levkropp/sesame-robot-pca9685/hardware/pcb/distro-v3/assets/close-v3.png

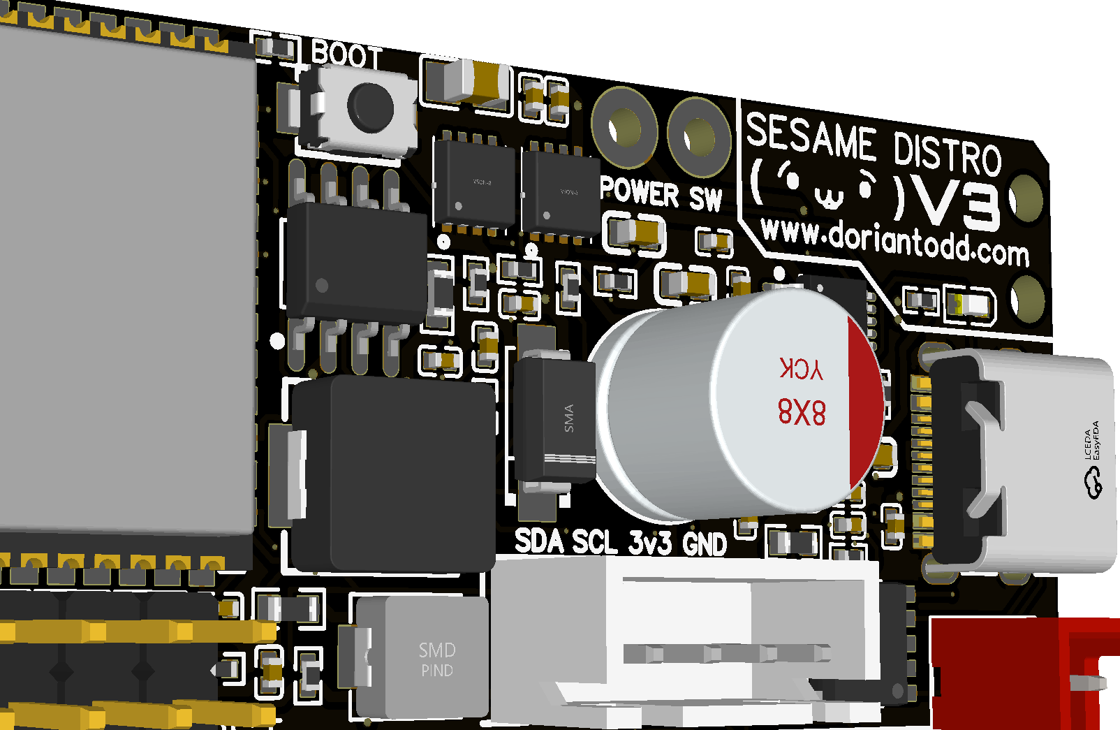
hardware/pcb/distro-v3/assets/close-v3.png
