levkropp/sesame-robot-pca9685/hardware/pcb/distro-v3/assets/Schematic_Sesame-Distro-Board-V3_2026-05-30.png

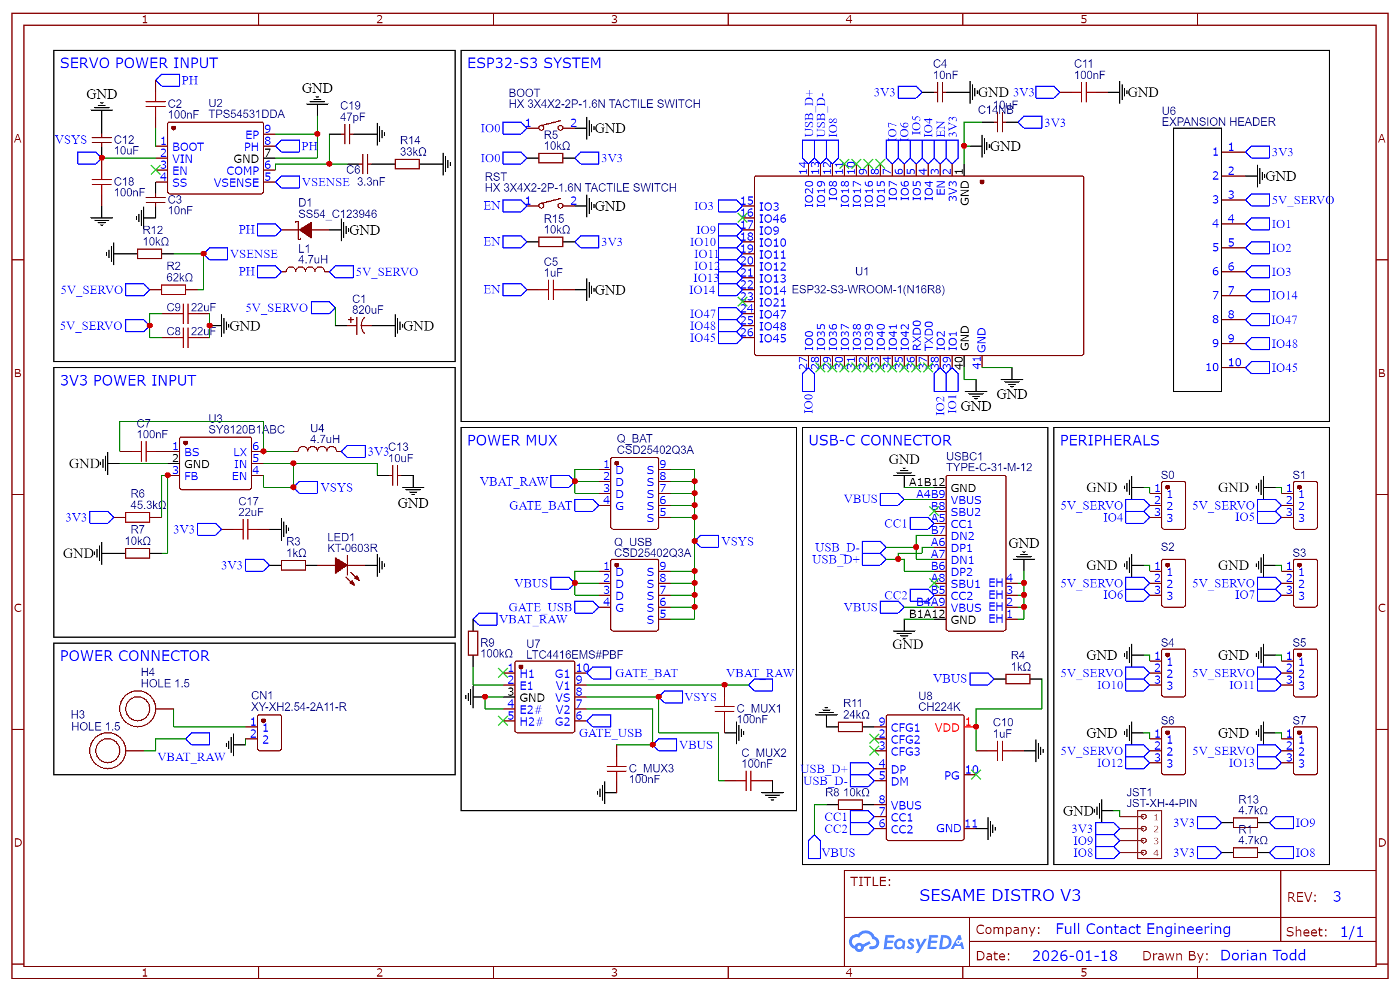
hardware/pcb/distro-v3/assets/Schematic_Sesame-Distro-Board-V3_2026-05-30.png
