levkropp/sesame-robot-pca9685/hardware/pcb/SDB-layout.png

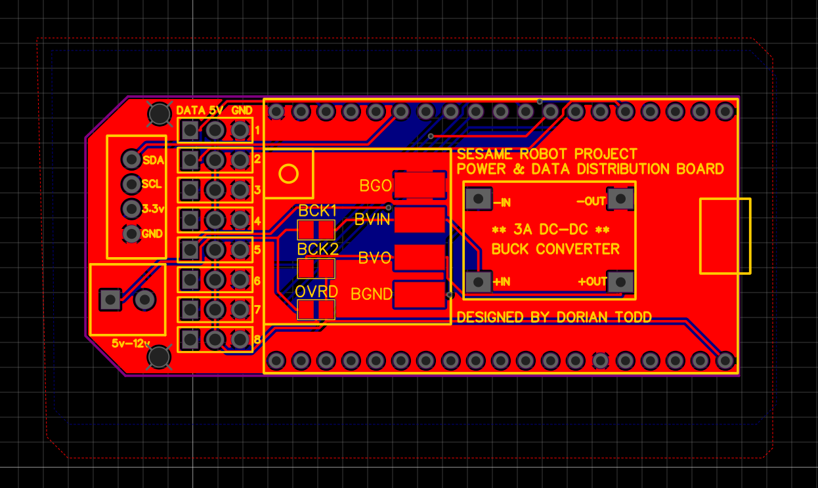
hardware/pcb/SDB-layout.png
