levkropp/sesame-robot-pca9685/software/sesame-studio/assets/sesame-sticker2.png

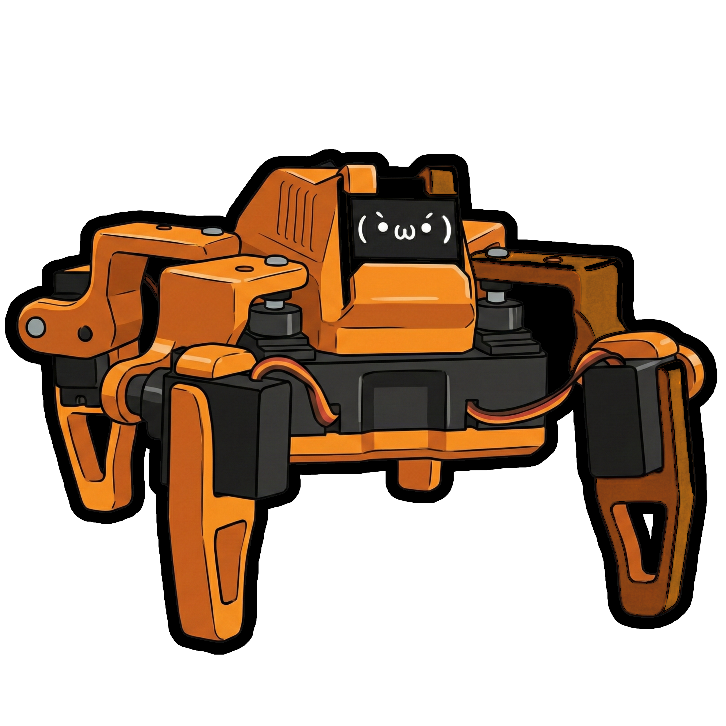
software/sesame-studio/assets/sesame-sticker2.png
