levkropp/sesame-robot-pca9685/software/sesame-studio/assets/sesamestudio-preview.png

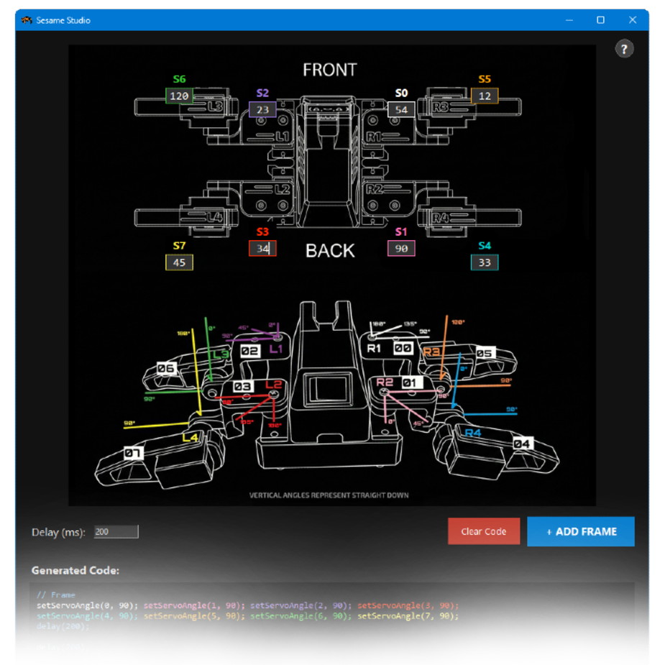
software/sesame-studio/assets/sesamestudio-preview.png
