levkropp/sesame-robot-pca9685/hardware/pcb/distro-v3/BOM_Sesame-Distro-Board-V3.csv

ID | Name | Designator | Footprint | Quantity | Manufacturer Part | Manufacturer | Supplier | Supplier Part | Price
1 | 1uF | C10 | C0402 | 1 | CC0402MRY5V6BB105 | YAGEO(国巨) | LCSC | C527031 | 0.006
2 | XY-XH2.54-2A11-R | CN1 | CONN-TH_2P-P2.50_C9900022029 | 1 | XY-XH2.54-2A11-R | XYECONN(辛译) | LCSC | C22391422 | 0.015
3 | 1kΩ | R4,R3 | R0402 | 2 | 0402WGF1001TCE | UNI-ROYAL(厚声) | LCSC | C11702 | 0.001
4 | 10kΩ | R8,R5,R7,R12,R15 | R0402 | 5 | 0402WGF1002TCE | UNI-ROYAL(厚声) | LCSC | C25744 | 0.001
5 | HX 3X4X2-2P-1.6N TACTILE SWITCH | RST,BOOT | KEY-SMD_L4.0-W3.0-LS4.9-1 | 2 | HX 3x4x2-2P-1.6N TACTILE SWITCH | hanxia(韩下) | LCSC | C49234124 | 0.019
6 | HOLE 1.5 | H3,H4 | HOLEHOLE | 2 |  |  |  | No Part Required
7 | LTC4416EMS#PBF | U7 | MSOP-10_L3.0-W3.0-P0.50-LS5.0-BL | 1 | LTC4416EMS#PBF | ADI(亚德诺) | LCSC | C694754 | 8.147
8 | 820uF | C1 | CAP-TH_BD8.0-P3.50-D0.6-FD | 1 | E2821M010D120RL | 瑞隆 | LCSC | C2898774 | 0.123
9 | 100nF | C2,C7,C18 | C0402 | 3 | VJ0402Y104KXJPW1BC | VISHAY(威世) | LCSC | C3891429 | 0.073
10 | 10nF | C4 | C0402 | 1 | CL05B103KB5NNNC | SAMSUNG(三星) | LCSC | C15195 | 0.002
11 | 1uF | C5 | C0402 | 1 | CL05A105KA5NQNC | SAMSUNG(三星) | LCSC | C52923 | 0.005
12 | 100nF | C11,C_MUX1,C_MUX2,C_MUX3 | C0402 | 4 | MC0402B104K500N5RH | Sunway(信维通信) | LCSC | C3152552
13 | 10uF | C12,C13,C14NB | C0402 | 3 | CL05A106MQ5NUNC | SAMSUNG(三星) | LCSC | C15525 | 0.017
14 | 47pF | C19 | C0402 | 1 | 0402CG470J500NT | FH(风华) | LCSC | C1567 | 0.001
15 | 4.7kΩ | R1,R13 | R0402 | 2 | 0402WGF4701TCE | UNI-ROYAL(厚声) | LCSC | C25900 | 0.001
16 | 100kΩ | R9 | R0402 | 1 | 0402WGF1003TCE | UNI-ROYAL(厚声) | LCSC | C25741 | 0.001
17 | 24kΩ | R11 | R0603 | 1 | 0603WAF2402T5E | UNI-ROYAL(厚声) | LCSC | C23352 | 0.002
18 | 33kΩ | R14 | R0402 | 1 | 0402WGF3302TCE | UNI-ROYAL(厚声) | LCSC | C25779 | 0.001
19 | 10nF | C3 | C0805 | 1 | CL21B103KBANNNC | SAMSUNG(三星) | LCSC | C1710 | 0.008
20 | 3.3nF | C6 | C0603 | 1 | CL10B332KB8NNNC | SAMSUNG(三星) | LCSC | C1613 | 0.006
21 | 22uF | C8,C9,C17 | C0603 | 3 | CL10A226MQ8NRNC | SAMSUNG(三星) | LCSC | C59461 | 0.013
22 | SS54_C123946 | D1 | SMA_L4.4-W2.8-LS5.4-RD | 1 | SS54 | 晶导微电子 | LCSC | C123946 | 0.052
23 | JST-XH-4-PIN | JST1 | JST-XH-4PIN-2.5 | 1 |  |  |  | C144395 | 0.054
24 | 4.7uH | L1 | IND-SMD_L7.0-W6.6_APH0630 | 1 | APH0630T4R7M | APV(爱普微) | LCSC | C5349705 | 0.072
25 | KT-0603R | LED1 | LED0603-RD | 1 | KT-0603R | KENTO | LCSC | C2286 | 0.007
26 | CSD25402Q3A | Q_BAT,Q_USB | VSONP-8_L3.1-W3.1-P0.65-LS3.5-BL | 2 | CSD25402Q3A | TI(德州仪器) | LCSC | C111356 | 0.638
27 | 62kΩ | R2 | R0603 | 1 | RT0603BRD0762KL | YAGEO(国巨) | LCSC | C136961 | 0.026
28 | 45.3kΩ | R6 | R0603 | 1 | RMC 0603 45K3 F N | Tyohm(幸亚电阻) | LCSC | C325695 | 0.004
29 | HX | S0 | HDR-TH_3P-P2.54-V-M-1 | 1 | HX PH254-01-03-Z-L11.5 pcb pin header | hanxia(韩下) | LCSC | C52016391 | 0.023
30 | HX PH254-01-03-Z-L11.5 PCB PIN HEADER | S1,S2,S3,S4,S5,S6,S7 | HDR-TH_3P-P2.54-V-M-1 | 7 | HX PH254-01-03-Z-L11.5 pcb pin header | hanxia(韩下) | LCSC | C52016391 | 0.023
31 | ESP32-S3-WROOM-1(N16R8) | U1 | WIRELM-SMD_ESP32-S3-WROOM-1 | 1 | ESP32-S3-WROOM-1-N16R8 | ESPRESSIF(乐鑫) | LCSC | C2913202 | 5.389
32 | TPS54531DDA | U2 | SOIC-8_L4.9-W3.9-P1.27-LS6.0-BL-EP2.9 | 1 | TPS54531DDA | TI(德州仪器) | LCSC | C544938 | 0.631
33 | SY8120B1ABC | U3 | SOT-23-6_L2.9-W1.6-P0.95-LS2.8-BL | 1 | SY8120B1ABC | Silergy(矽力杰) | LCSC | C88474 | 0.161
34 | 4.7uH | U4 | IND-SMD_L4.4-W4.2 | 1 | APH0420T4R7M | APV(爱普微) | LCSC | C5349668 | 0.081
35 | EXPANSION HEADER | U6 | HEADER MALE 2.54-1*10 | 1 |  |  |  | No Part Required
36 | CH224K | U8 | ESSOP-10_L4.9-W3.9-P1.0-LS6.0-TL-EP | 1 | CH224K | WCH(南京沁恒) | LCSC | C970725 | 0.616
37 | TYPE-C-31-M-12 | USBC1 | USB-C_SMD-TYPE-C-31-M-12_1 | 1 | TYPE-C-31-M-12 | 韩国韩荣 | LCSC | C165948 | 0.188
