levkropp/sesame-robot-pca9685/hardware/printing/stl/R1-v117.stl

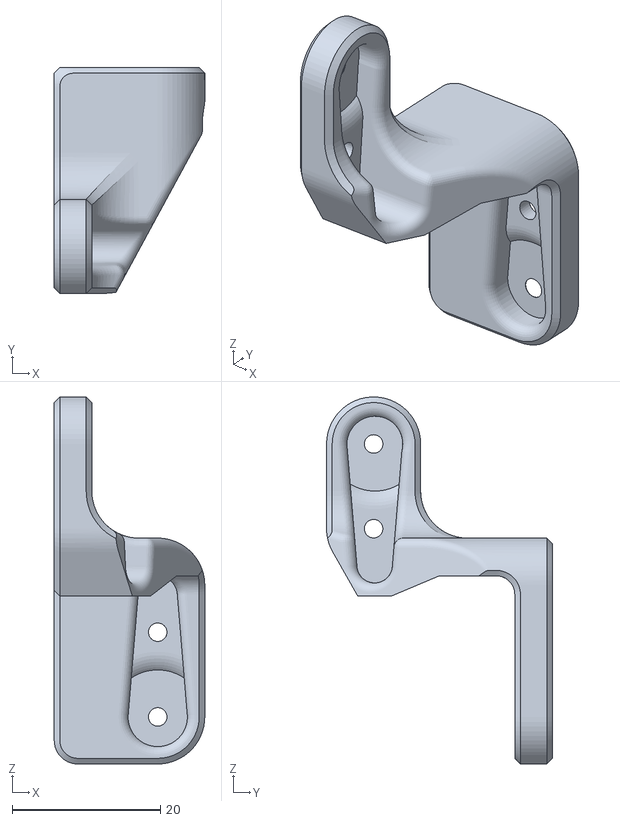
[picture p9: CAD file, 2026-07-29]
hardware/printing/stl/R1-v117.stl
20.3 x 30.5 x 49.5
