levkropp/sesame-robot-pca9685/hardware/printing/stl/top-covers/hats/magnetic-modular-mount-hat.stl

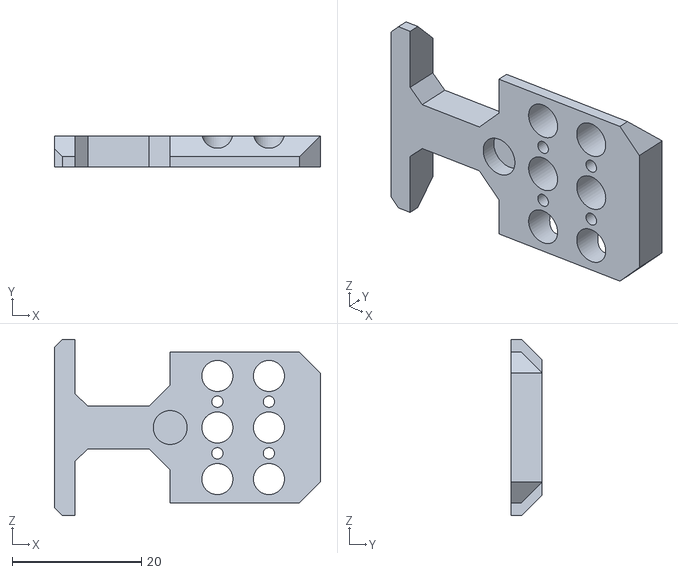
[picture p10: CAD file, 2026-07-29]
hardware/printing/stl/top-covers/hats/magnetic-modular-mount-hat.stl
41.1 x 4.79 x 27.3
