levkropp/sesame-robot-pca9685/hardware/printing/stl/top-covers/Top-Cover-Cat-v100.stl

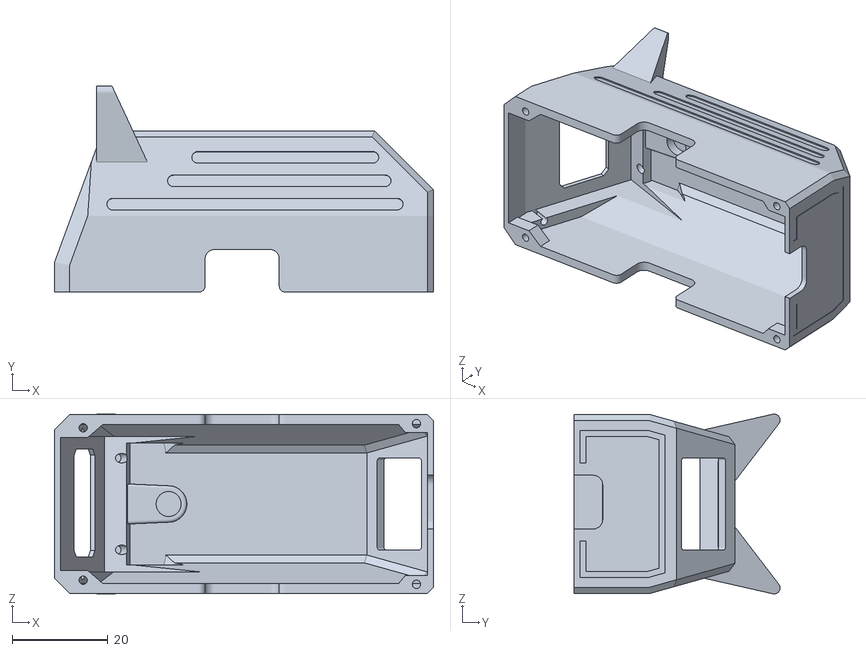
[picture p11: CAD file, 2026-07-29]
hardware/printing/stl/top-covers/Top-Cover-Cat-v100.stl
79.2 x 43.1 x 37.6
