levkropp/sesame-robot-pca9685/hardware/printing/stl/top-covers/hats/magnetic-chainsaw-hat.stl

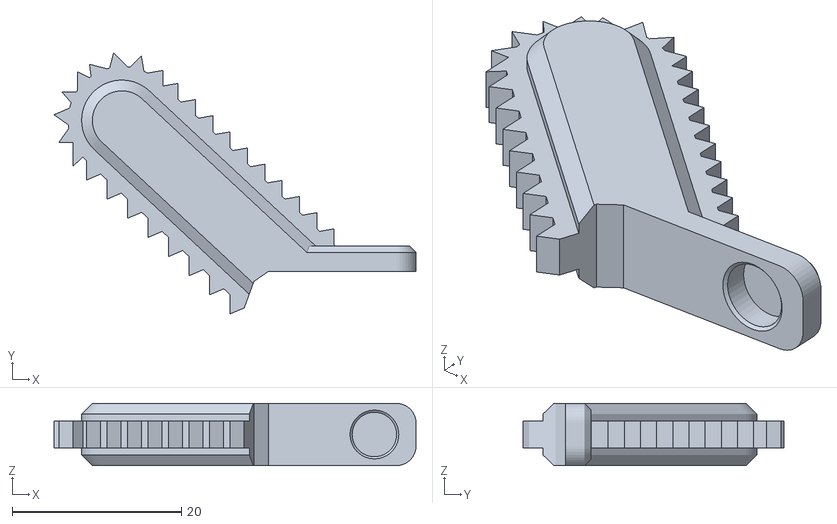
[picture p12: CAD file, 2026-07-29]
hardware/printing/stl/top-covers/hats/magnetic-chainsaw-hat.stl
42.8 x 30.8 x 7.34
