levkropp/sesame-robot-pca9685/hardware/printing/stl/top-covers/Top-Cover-Enclosed-v117.stl

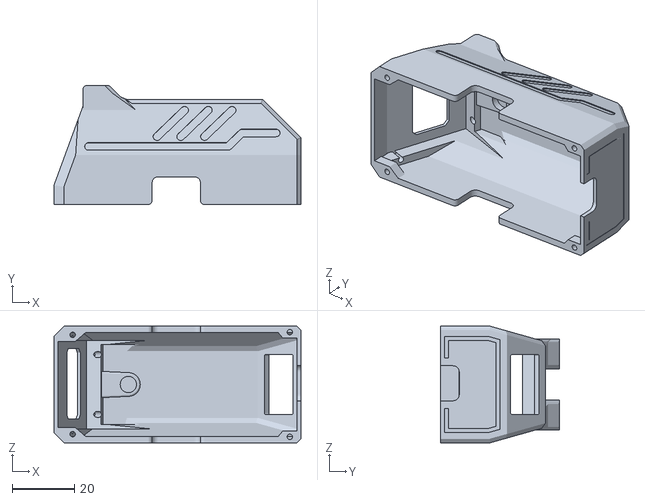
[picture p13: CAD file, 2026-07-29]
hardware/printing/stl/top-covers/Top-Cover-Enclosed-v117.stl
79.2 x 38.2 x 37.4
