levkropp/sesame-robot-pca9685/hardware/printing/stl/L3-v117.stl

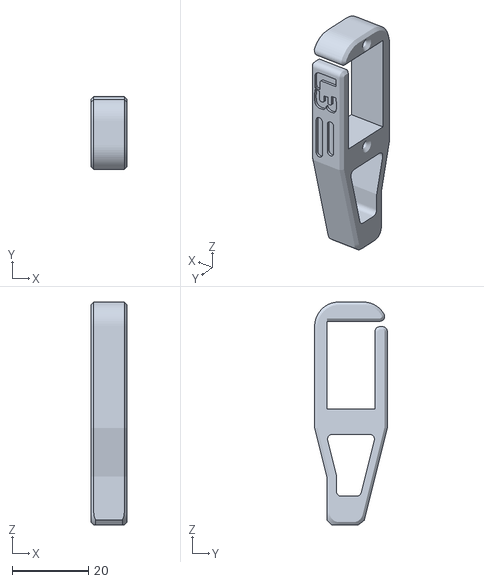
[picture p14: CAD file, 2026-07-29]
hardware/printing/stl/L3-v117.stl
9.53 x 19.0 x 58.4
