levkropp/sesame-robot-pca9685/hardware/printing/stl/top-covers/Top-Cover-No-Ears-v100.stl

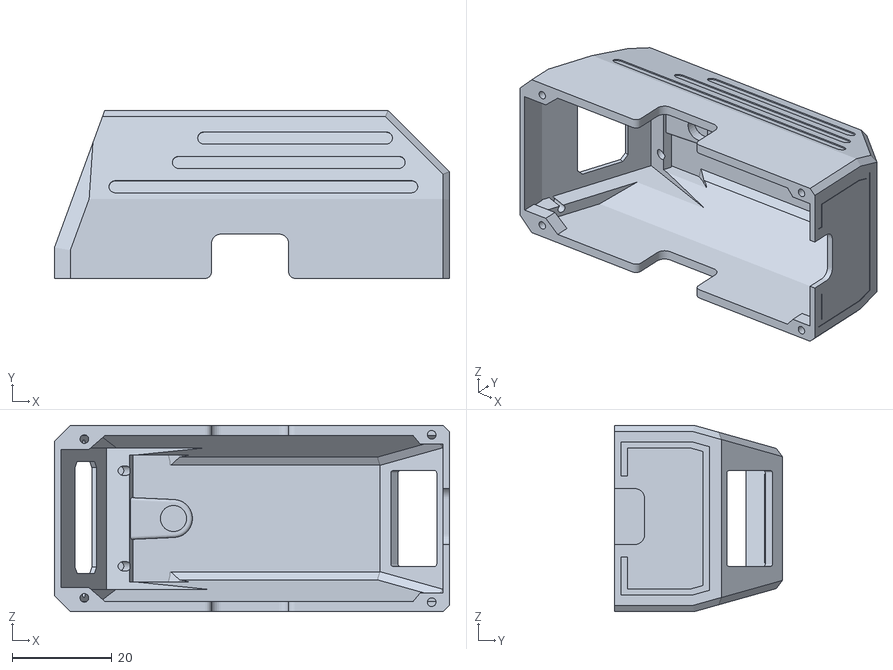
[picture p15: CAD file, 2026-07-29]
hardware/printing/stl/top-covers/Top-Cover-No-Ears-v100.stl
79.2 x 33.7 x 37.4
