levkropp/sesame-robot-pca9685/hardware/printing/stl/Internal-Frame-v121.stl

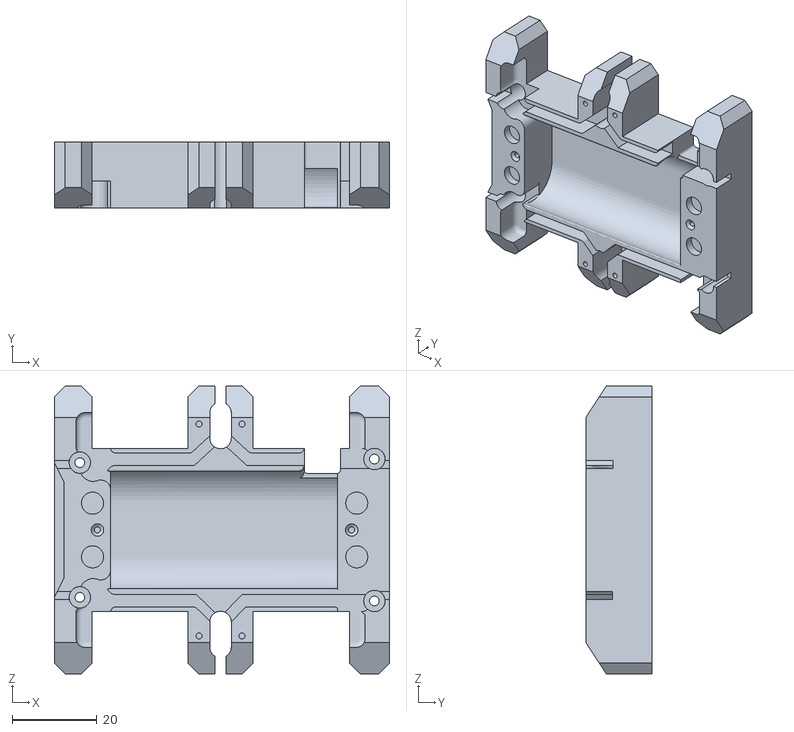
[picture p16: CAD file, 2026-07-29]
hardware/printing/stl/Internal-Frame-v121.stl
79.2 x 15.7 x 68.1
