levkropp/sesame-robot-pca9685/hardware/printing/stl/Bottom-Cover-v121.stl

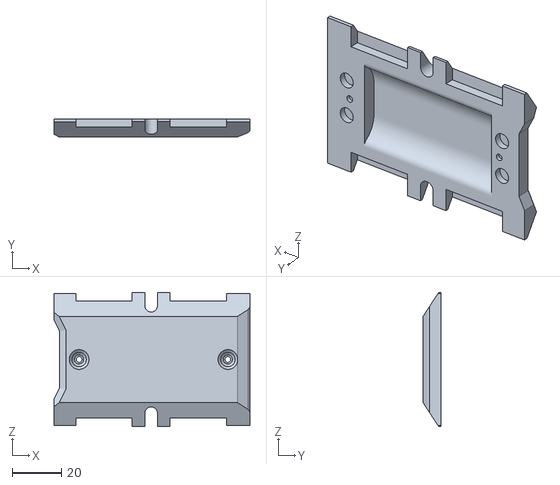
[picture p17: CAD file, 2026-07-29]
hardware/printing/stl/Bottom-Cover-v121.stl
79.2 x 7.27 x 54.2
