levkropp/sesame-robot-pca9685/(list of files, cad)

Other CAD files:
hardware/printing/stl/R2-v117.stl
hardware/printing/stl/L1-v117.stl
hardware/printing/stl/top-covers/Top-Cover-Enclosed-v117-PCA9685-sunroof.stl
hardware/printing/stl/L4-v117.stl
hardware/printing/stl/top-covers/Top-Cover-Enclosed-v117-shell-only.stl
hardware/printing/stl/R4-v117.stl
hardware/printing/stl/L2-v117.stl
hardware/printing/stl/R3-v117.stl
