levkropp/sesame-robot-pca9685/hardware/printing/README.md

# 3D Printing Guide

Sesame is designed to be printed in **PLA**. Most parts print without supports, but the top cover needs supports in targeted areas. Below is a quick reference for each component:

Note: There are 3 different top cover styles currently available. **Enclosed v91 is recommended** as it's the most modern design with magnetic hat mounts, covered display wires, and multicolor detail support. See [Top Covers](stl/top-covers/) for details on all styles.

> [!NOTE]
> **Battery Upgrade:** The internal frame design has been slightly altered to fit the new recommended battery (Bambu Lab 14500 Li-ion). If you have an older Sesame and want to upgrade to this battery, simply print the new internal frame and install it.

## Recommended Settings

* **Material:** PLA / PLA+
* **Infill:** 8-10%
* **Wall Loops:** 2
* **Infill Pattern:** Honeycomb

## 3D Printed Components Support Guide

| Component | Supports Required | STL Link |
| --- | --- | --- |
| Joint R1 | No | [R1-v117.stl](stl/R1-v117.stl) |
| Joint R2 | No | [R2-v117.stl](stl/R2-v117.stl) |
| Joint R3 | No | [R3-v117.stl](stl/R3-v117.stl) |
| Joint R4 | No | [R4-v117.stl](stl/R4-v117.stl) |
| Joint L1 | No | [L1-v117.stl](stl/L1-v117.stl) |
| Joint L2 | No | [L2-v117.stl](stl/L2-v117.stl) |
| Joint L3 | No | [L3-v117.stl](stl/L3-v117.stl) |
| Joint L4 | No | [L4-v117.stl](stl/L4-v117.stl) |
| Internal Frame | No | [Internal-Frame-v121.stl](stl/Internal-Frame-v121.stl) |
| Bottom Cover | No | [Bottom-Cover-v121.stl](stl/Bottom-Cover-v121.stl) |
| Top Cover | Yes | [Top Covers](stl/top-covers/) |

### Top Cover Settings (Original Style)

Brim: Outer brim only
Support type: Normal (Manual)

Manual support locations:

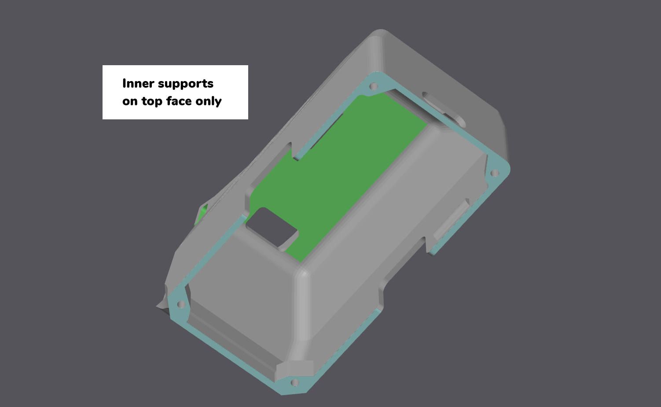
[picture p48: hardware/printing/assets/topcover-supports2.png]
topcover-supports2


This is what the part should look like sliced:

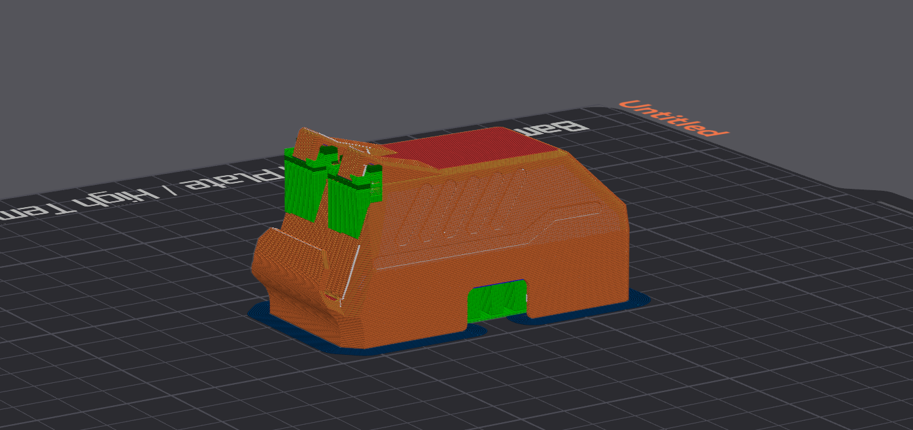
[picture p49: hardware/printing/assets/sliced-topcover.png]
sliced-topcover


### Recommended Print Orientation for Joints:

Using the auto orientate tool will place these the correct way.

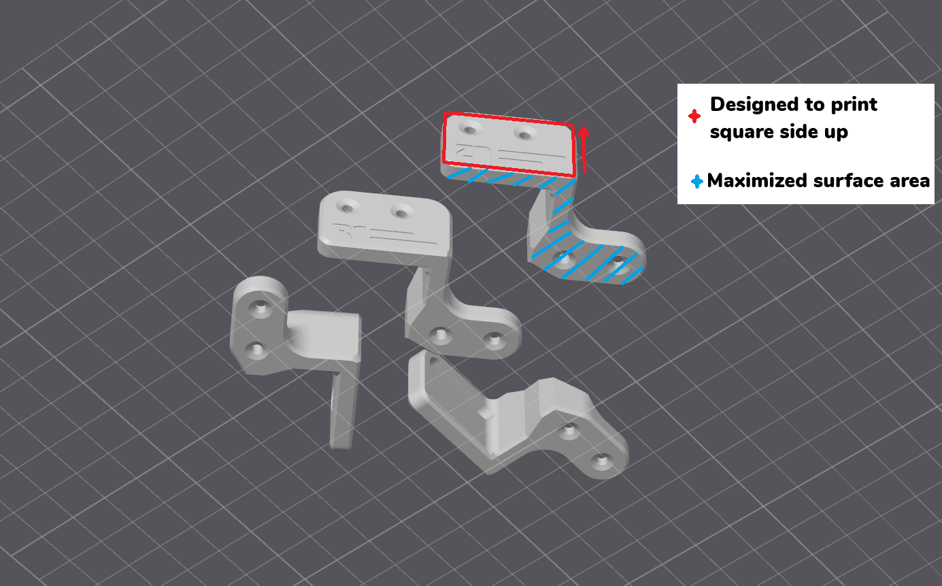
[picture p50: hardware/printing/assets/joints-orientation.png]
