levkropp/sesame-robot-pca9685/docs/build-guide/assets/display-wires.png

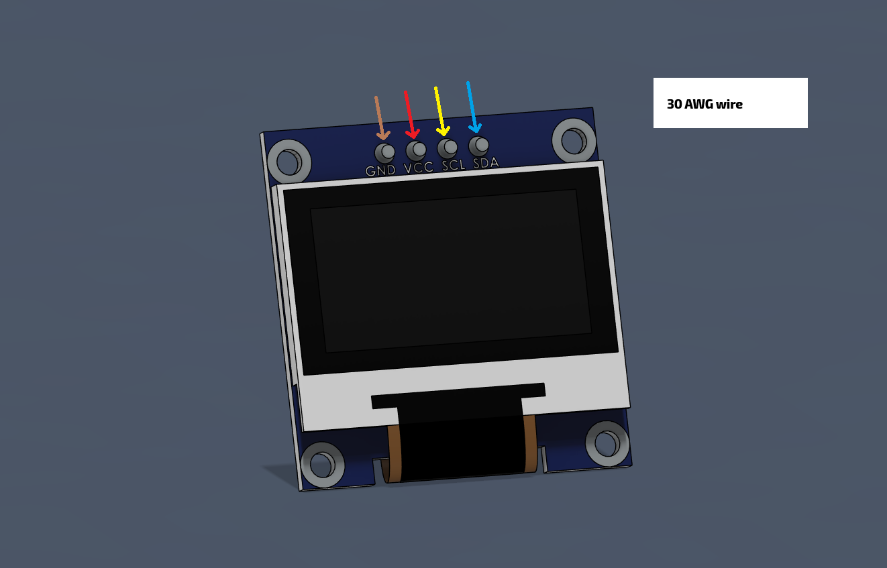
docs/build-guide/assets/display-wires.png
