levkropp/sesame-robot-pca9685/docs/build-guide/assets/insert-display.png

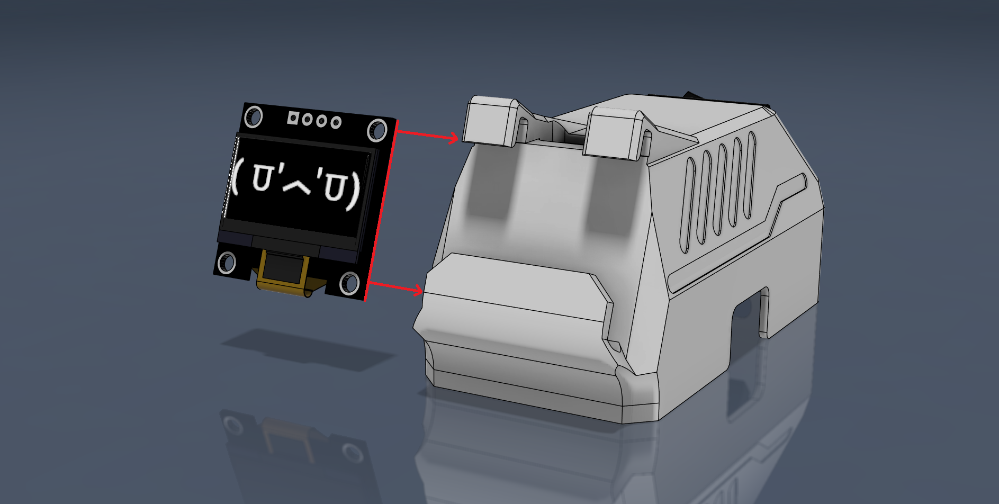
docs/build-guide/assets/insert-display.png
