levkropp/sesame-robot-pca9685/docs/build-guide/assets/joint-horn-install-2.png

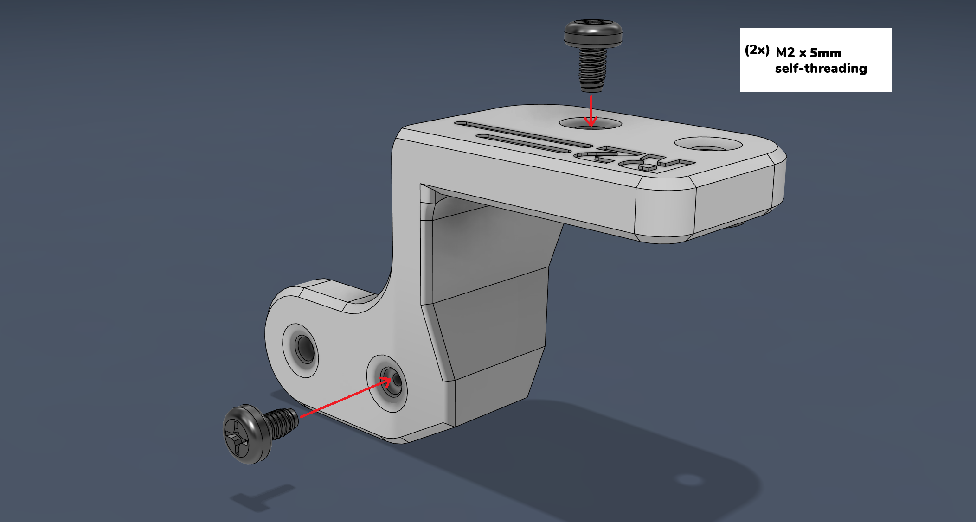
docs/build-guide/assets/joint-horn-install-2.png
