levkropp/sesame-robot-pca9685/docs/build-guide/assets/joints-preassem.png

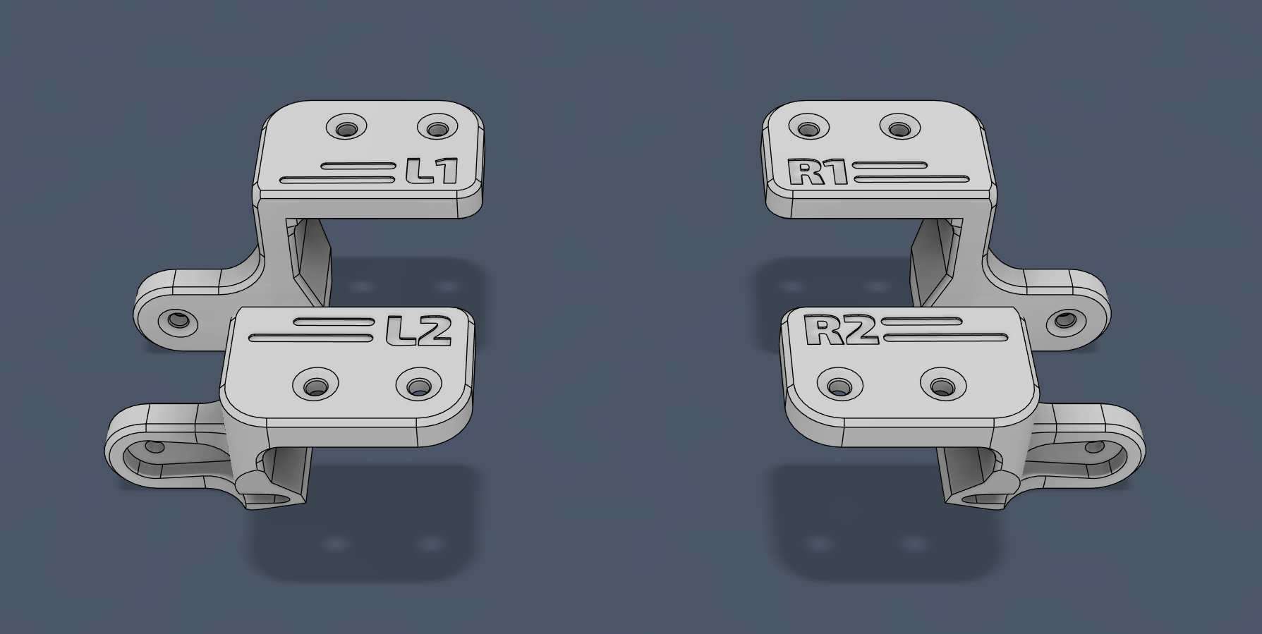
docs/build-guide/assets/joints-preassem.png
