levkropp/sesame-robot-pca9685/docs/build-guide/assets/press-on-bottom-cover.png

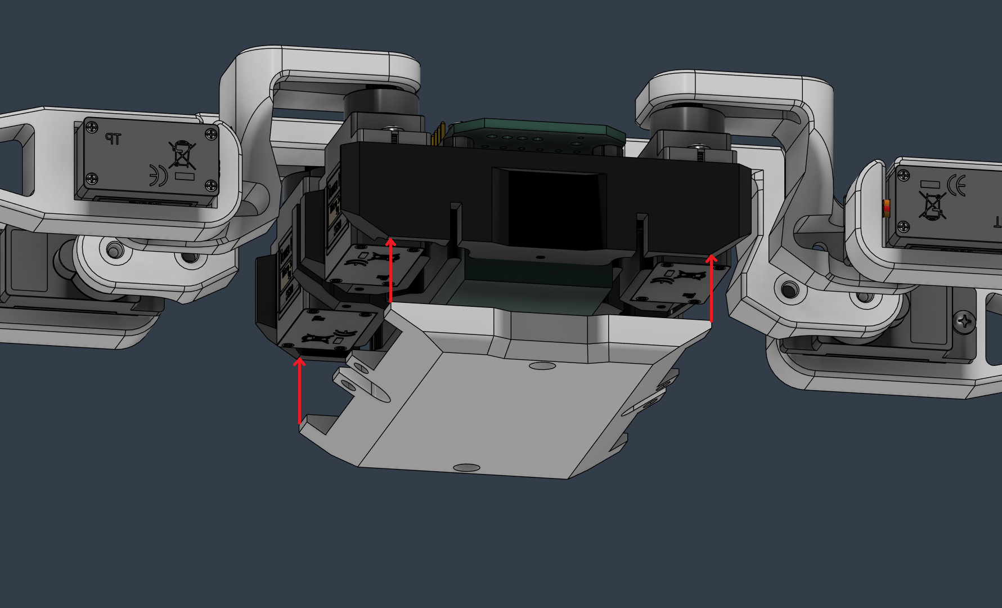
docs/build-guide/assets/press-on-bottom-cover.png
