levkropp/sesame-robot-pca9685/docs/build-guide/assets/push-on-top-cover.png

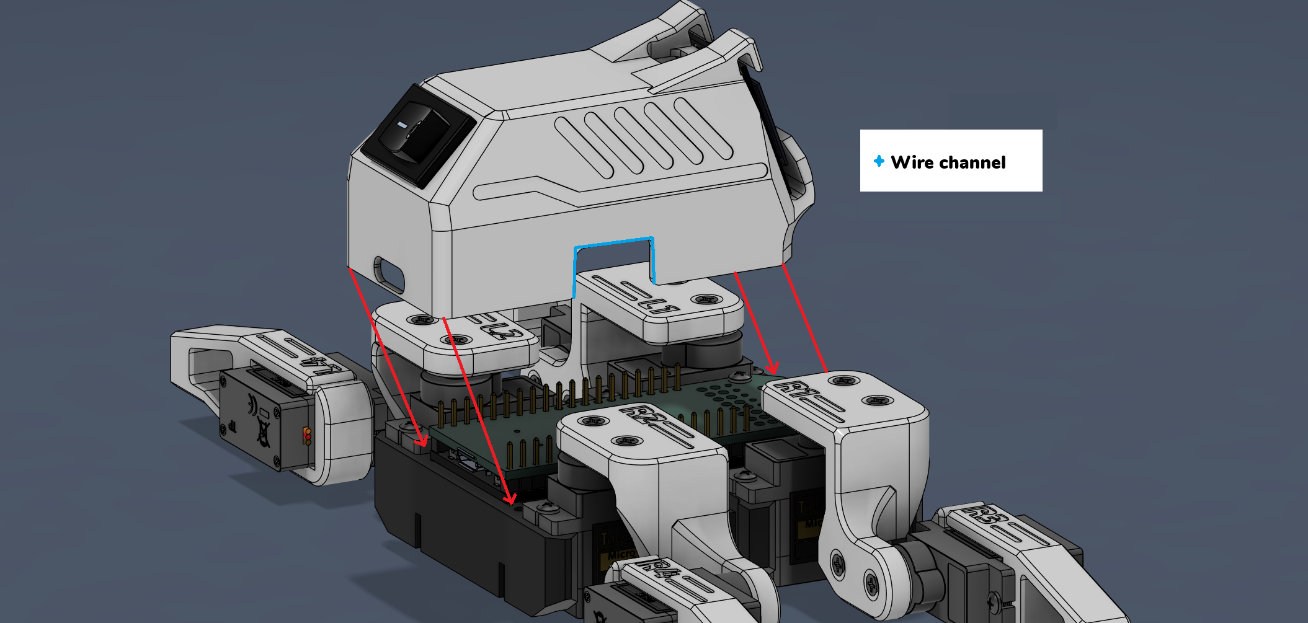
docs/build-guide/assets/push-on-top-cover.png
