levkropp/sesame-robot-pca9685/docs/build-guide/assets/remove-headers.png

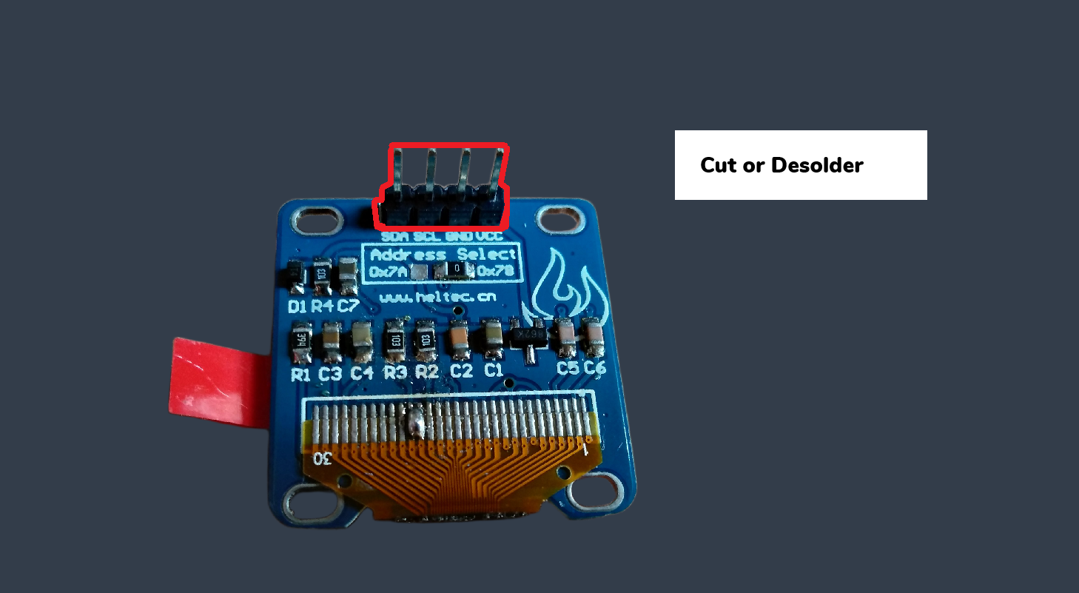
docs/build-guide/assets/remove-headers.png
