levkropp/sesame-robot-pca9685/docs/build-guide/assets/securing-display-enclosed.png

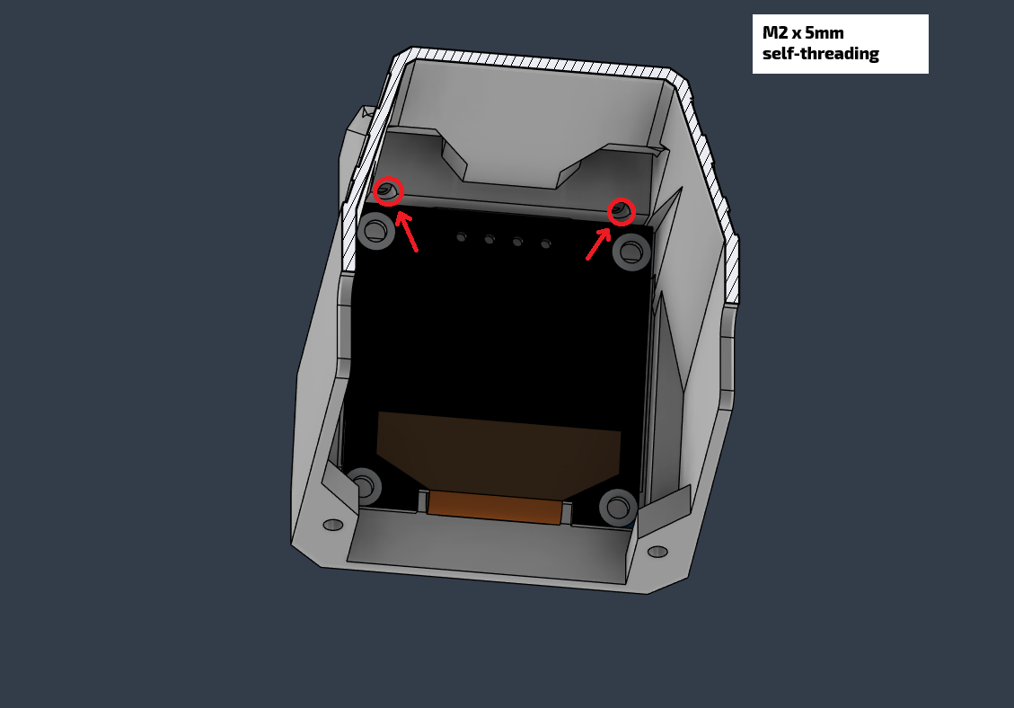
docs/build-guide/assets/securing-display-enclosed.png
