levkropp/sesame-robot-pca9685/docs/build-guide/assets/securing-display.png

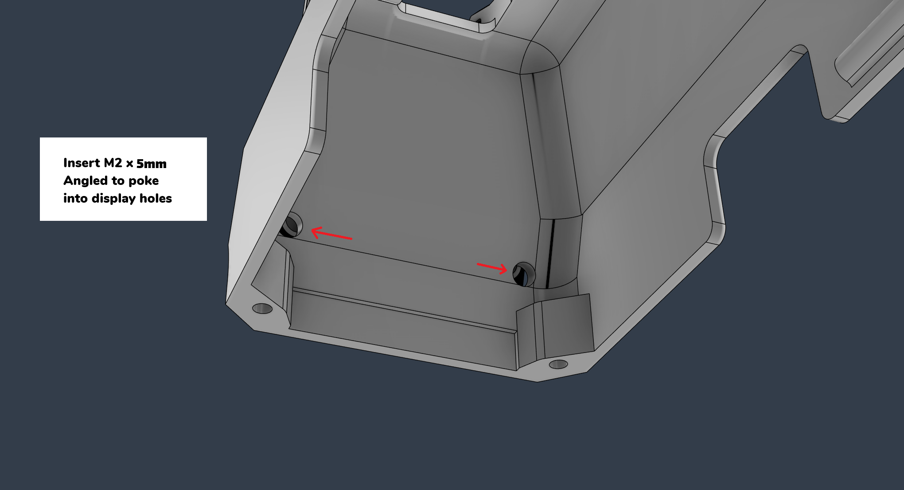
docs/build-guide/assets/securing-display.png
