levkropp/sesame-robot-pca9685/docs/build-guide/assets/top-cover-wiring.png

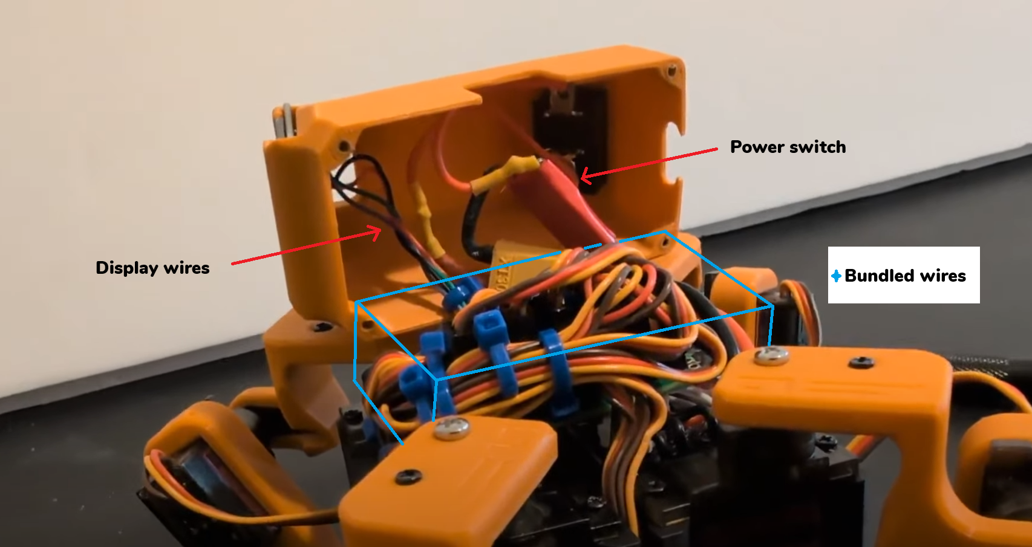
docs/build-guide/assets/top-cover-wiring.png
