levkropp/sesame-robot-pca9685/docs/build-guide/assets/wire-spot.png

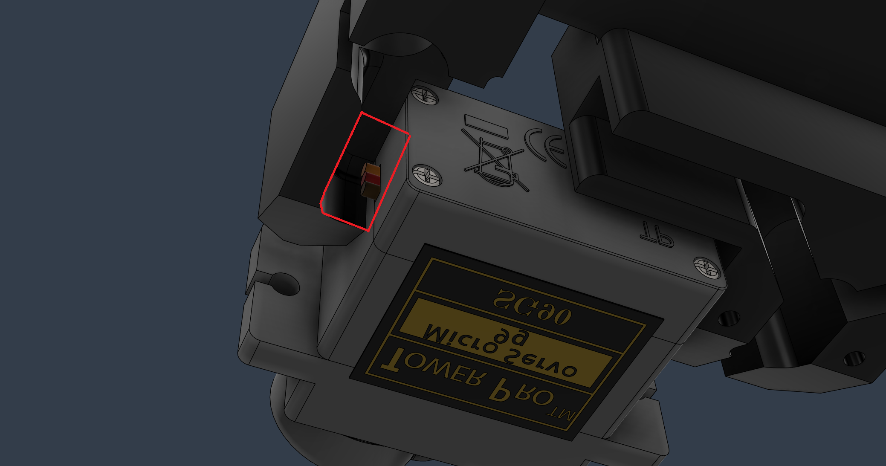
docs/build-guide/assets/wire-spot.png
