levkropp/sesame-robot-pca9685/docs/pca9685-fork/assets/wiring-diagram.png

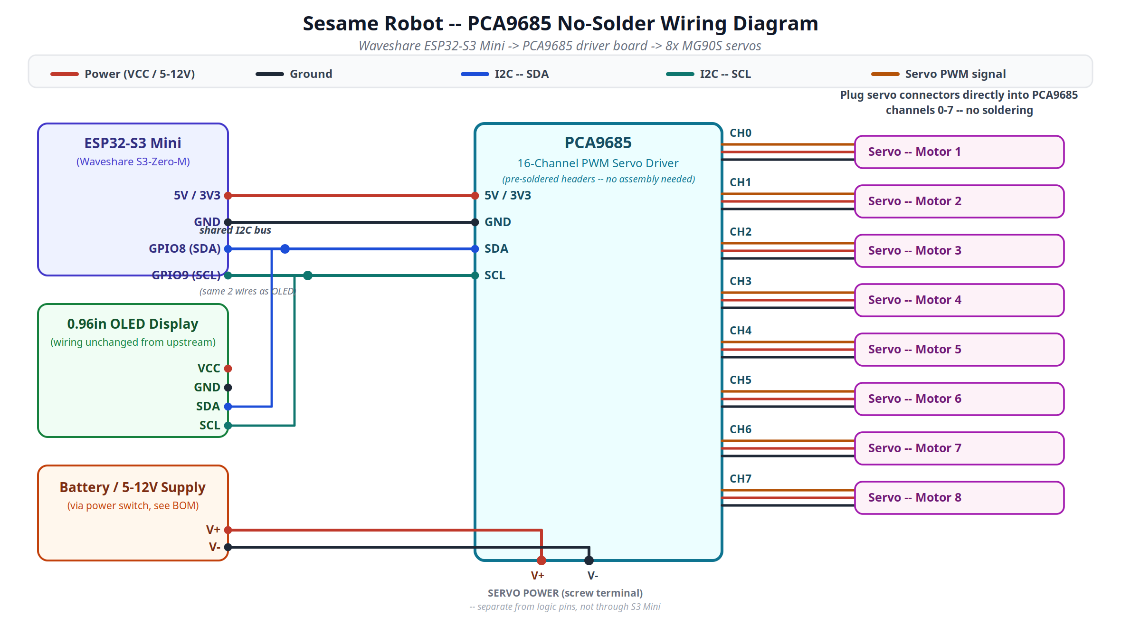
docs/pca9685-fork/assets/wiring-diagram.png
