levkropp/sesame-robot-pca9685/hardware/printing/assets/topcover-supports1.png

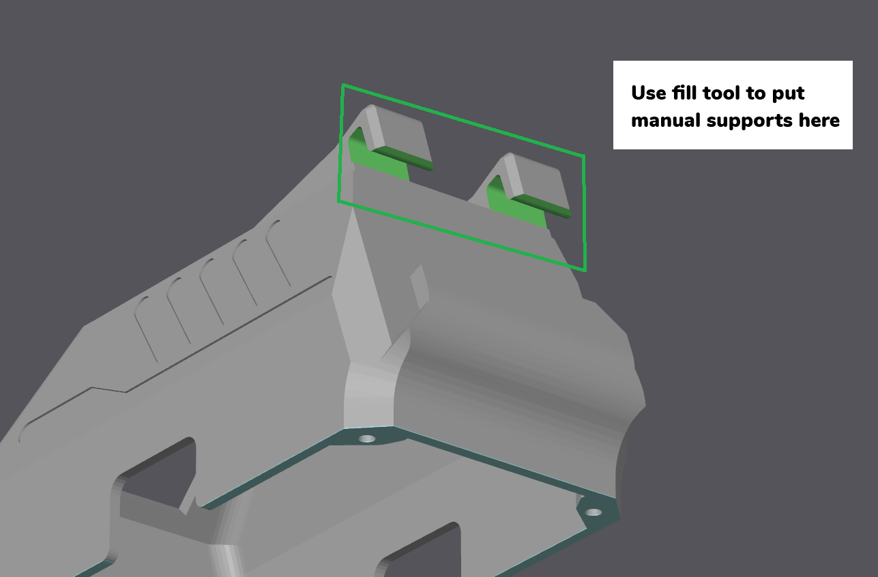
hardware/printing/assets/topcover-supports1.png
