levkropp/sesame-robot-pca9685/(commit log)

2026-07-29 Sesame Robot — PCA9685 no-solder edition (fork of dorianborian/sesame-robot)
    Swaps the hand-wired 3x8 servo header block for a plug-and-play PCA9685
    driver board paired with a pre-soldered Waveshare ESP32-S3-Zero-M, making
    the whole electronics stack zero-solder:
    - firmware: servos driven via Adafruit_PWMServoDriver over I2C (GPIO8/9)
    instead of direct GPIO PWM
    - docs: wiring guide, BOM (two-phase power: tethered USB-C first, battery
    later), fork writeup, corrected 'sunroof' top-cover STL + parametric
    OpenSCAD source for PCA9685 connector access
    - website/: static explainer site, deployed to GitHub Pages by CI
    - simulation/: complete Velxio project (.vlx) that boots the real firmwar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
    [BOM_Sesame-Distro-Board-V3.csv, BOM_Sesame-Distro-V2.csv, Bottom-Cover-v121.stl, Internal-Frame-v121.stl, L1-v117.stl, L2-v117.stl, L3-v117.stl, L4-v117.stl]
2026-07-29 Fix servo power routing in .vlx: servos draw V+/GND through the PCA9685 rail (like the physical module), PSU only feeds the screw terminal
    [generate_vlx.py]
2026-07-29 Event-driven PCA9685 chip + verified end-to-end ESP32-S3 emulation
    - Re-vendor event-driven PCA9685 chip (edge-scheduled one-shot timers,
    global 20ms frame clock, no tick quantization); regenerate .vlx
    - simulation/velxio-patches/: three runtime fixes needed to run ESP32-S3 +
    custom chips on the published velxio master image (timer resync,
    one-shot re-arm preservation, WASM store entry RLock), the chip-timer
    clock fix in esp32_worker, and the esp32s3 boot ROM the image lacks
    - simulation/velxio_headless_test.py: full headless driver that compiles
    via the backend API, boots the firmware on the emulated S3, and drives
    animations over the serial CLI
    - Verified live: firmware boots,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
    [esp32_worker.py, pca9685.c, test_chip.py, velxio_headless_test.py, wasm_chip_runtime.py]
2026-07-29 Fix esp32s3 WiFi NIC segfault + clean library manifest
    Root cause of the 'ESP32 crash detected - cache error (IDF incompatibility)'
    banner: the frontend sends wifi_enabled=true by default for ESP32 boards,
    and the esp32s3-picsimlab machine has no esp32_wifi device model in this
    QEMU build ('requested NIC was not created (not supported by this
    machine?)'), which intermittently SIGSEGVs (-11) during machine init. The
    banner text was a red herring - it is a hardcoded UI string, not a
    diagnosis. esp32_worker.py now skips the unsupported NIC on esp32s3 and
    continues without network (verified: wifi_enabled=True now boots clean).
    Also adds Adafruit BusIO to the .vlx board library manifest so the s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
    [esp32_worker.py, generate_vlx.py, wasm_chip_runtime.py]
2026-07-30 Sync behavioral test robustness fix from chip repo
    [test_chip.py]
2026-07-30 Root cause + fix for the persistent esp32-s3 -11 crash: synthetic pin set_pin OOB
    The frontend builds pin_map for custom chips with synthetic pin numbers
    (100000+) for chip pins wired to non-board components (e.g. servos). During
    chip setup the runtime writes initial LOW to every OUTPUT pin via
    qemu_picsimlab_set_pin - including those synthetic slots, which are far
    outside the 40-slot QEMU GPIO table, so the write goes out of bounds and
    SIGSEGVs during/just after machine init. This was the actual cause of the
    repeated worker_exit code: -11 crashes (the 'cache error (IDF
    incompatibility)' banner is a hardcoded UI string, not a diagnosis).
    Fix: _chip_pin_writer now only calls set_pin for real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
    [esp32_lib_manager.py, esp32_worker.py]
2026-07-30 Sync host-independent behavioral test + document set_pin OOB fix in patches README
    [test_chip.py]
