levkropp/sesame-robot-pca9685/(notices)

Notices in the files:
README.md:
License: APACHE2.0
